Ahmedvini/Jenga-Sustainable-FPGA-CubeSat/docs/architecture/schematic.png

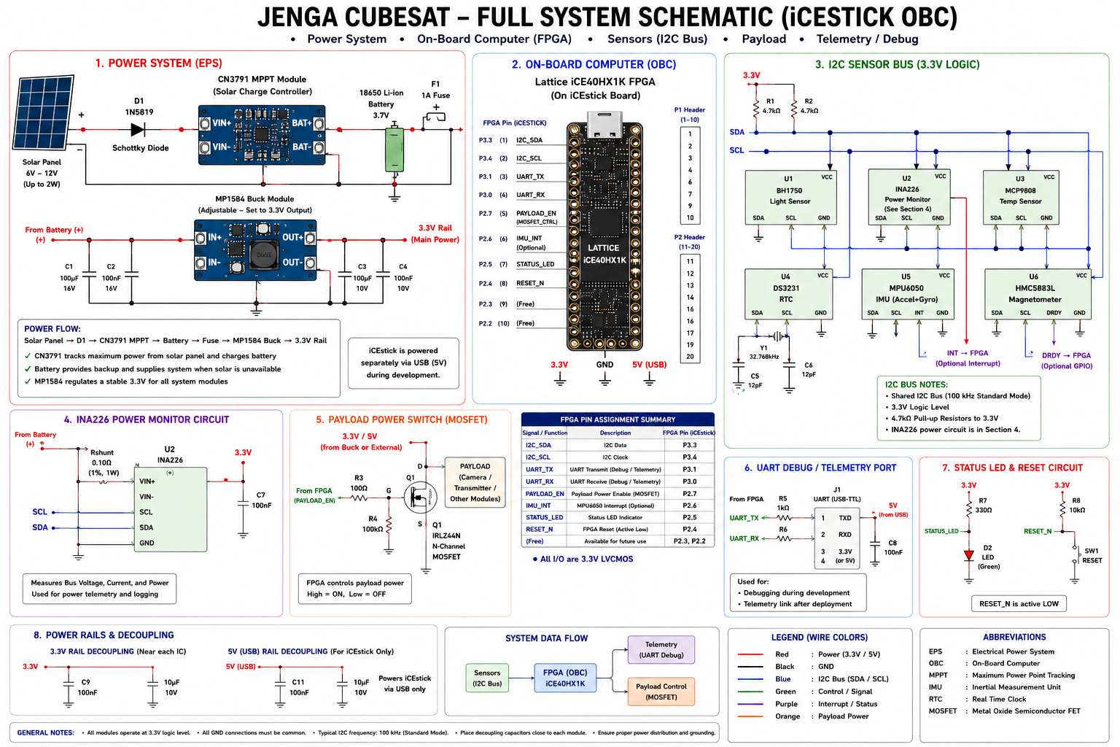
docs/architecture/schematic.png
