Ahmedvini/Jenga-Sustainable-FPGA-CubeSat/docs/architecture/SYSTEM_ARCHITECTURE.md

# Jenga CubeSat Prototype — System Architecture

FPGA-based CubeSat On-Board Computer (OBC) prototype. One iCE40HX1K
FPGA implements all control and data-path logic as HDL finite-state
machines: **no soft CPU, no OS, no DSP macros**. This document covers
hardware, power, sensors, communication, telemetry flow, the OBC
itself, module interactions, and the HX1K resource budget.

## 1. Hardware architecture

Full wiring detail — including iCEstick pin assignments, decoupling,
and the reset/status circuits — is in the drawn schematic:
[`schematic.png`](schematic.png). The block view:

```mermaid
flowchart TB
    subgraph EPS[Electrical power subsystem]
        SP[Solar panel 6V 2W] --> D1[1N5819] --> CHG[CN3791 MPPT]
        CHG --> BAT[18650 Li-ion 1S]
        BAT --> F[1A fuse] --> BUCK[MP1584 buck 3.3V]
    end
    subgraph OBC[OBC — iCEstick iCE40HX1K]
        SCH[Scheduler FSM]
        PWR[Power controller FSM]
        ORB[Orbit controller]
        DP[CAN filter / RLE / FIR]
        I2CM[I2C master FSM*]
        TLM[Telemetry FSM + UART TX*]
    end
    BUCK --> SBUS[3.3V sensor rail]
    SBUS --> S1[MPU6050] & S2[HMC5883L] & S3[BH1750] & S4[INA226] & S5[MCP9808] & S6[DS3231]
    SBUS --> PL[IRLZ44N payload switch]
    PL --> PAY[Payload]
    USB[USB 5V dev power] --> OBC
    I2CM <-->|shared I2C| S1 & S2 & S3 & S4 & S5 & S6
    PWR -->|gate drive| PL
    TLM -->|UART| GS[Laptop ground station]
```

\* Modules marked with an asterisk are staged (see Roadmap); all others
are implemented and synthesized today.

Design rules: single 12 MHz clock domain; all grounds common; FPGA
powered from USB during development (flight variant would take the
3.3 V rail); every off-chip interface is 3.3 V logic.

## 2. Power architecture

Chain: **Solar panel → 1N5819 → CN3791 MPPT → 18650 → 1 A fuse →
MP1584 → 3.3 V rail → sensors / payload switch**.

| Stage | Part | Function | Notes |
| --- | --- | --- | --- |
| Harvest | 6 V 2 W mono panel | ≤ ~330 mA at Vmp ≈ 6 V | indoor demo uses a desk lamp |
| Reverse block | 1N5819 | stops night-time reverse leakage | ~0.3 V drop |
| Charge | CN3791 | PWM MPPT, CC/CV to 4.20 V, single cell | MPPT setpoint resistor-set to panel Vmp |
| Store | 18650 (1S) | 3.0–4.2 V, ~2.5–3.5 Ah | protected holder, one cell only |
| Protect | 1 A fuse | limits fault current | system worst case < 0.5 A |
| Regulate | MP1584 | buck to 3.3 V | **dropout risk below ~3.6 V battery — see risk P1** |
| Distribute | 3.3 V rail | sensors + payload switch | INA226 monitors rail/battery current |

**Risk P1 (known, accepted for the bench):** MP1584 is buck-only; from
a 1S cell the 3.3 V output loses regulation as the battery approaches
~3.5 V. Mitigations, in preference order: (a) treat SOC < ~30% as
safe-mode cutoff (matches the 35% FPGA-activation threshold in the
policy), (b) swap MP1584 for a buck-boost module, (c) run the rail at
3.0 V (all six sensors accept it). Decision tracked in the roadmap.

The FSM policy maps to real hardware as: `comms_power_en` /
`fpga_power_en` (power_controller.v) → IRLZ44N gate (100 kΩ pulldown +
100 Ω series gate resistor, per `schematic.png` section 5). IRLZ44N is
logic-level; at 3.3 V drive keep switched loads ≤ ~2 A.

## 3. Sensor architecture

Single shared I2C bus, **one master** (the FPGA), 100 kHz standard
mode, 4.7 kΩ pull-ups to 3.3 V (disable extra breakout pull-ups if the
combined value drops below ~1.5 kΩ).

| Sensor | Measures | I2C address | Role in mission model |
| --- | --- | --- | --- |
| MPU6050 | 3-axis accel + gyro | **`0x69` (AD0 tied high — required!)** | attitude/tumble telemetry |
| HMC5883L | 3-axis magnetometer | `0x1E` | coarse attitude reference |
| BH1750 | ambient light | `0x23` (ADDR low) | **sunlight/eclipse detection** — can replace the free-running orbit counter with measured orbit state |
| INA226 | bus voltage + current (shunt) | `0x40` | **measured power** — turns simulated savings into live measured evidence |
| MCP9808 | temperature | `0x18` | thermal telemetry |
| DS3231 | RTC | `0x68` (fixed) | mission time-stamping; forces MPU6050 to `0x69` |

**Address plan note:** DS3231 is hard-wired to `0x68`, which is the
MPU6050 default — the MPU6050 breakout's AD0 pin must be strapped high.
No other conflicts exist in this suite.

Polling: one round-robin sensor-sequencer FSM behind the single I2C
master; sample rates follow the power policy (10 Hz-class in sunlight,
1 Hz-class in eclipse), mirroring `simulation/subsystems/sensing_module.py`.

## 4. Communication architecture

| Link | Direction | Use |
| --- | --- | --- |
| I2C (shared, FPGA master) | FPGA ↔ sensors | acquisition + RTC |
| UART (3.3 V, 115200 8N1 target) | FPGA → laptop | telemetry downlink stand-in |
| CAN (modeled) | on-board bus in the reference model | the RTL CAN packet filter demonstrates the flight bus policy; the bench has no physical CAN transceiver |

No RF hardware exists anywhere in the prototype. The UHF radio is a
modeled load in the reference simulation only.

## 5. Telemetry flow

```mermaid
sequenceDiagram
    participant S as I2C sensors
    participant M as I2C master + sequencer
    participant F as FIR filter
    participant R as RLE compressor
    participant E as packet_encoder
    participant B as telemetry FIFO (SB_RAM4K)
    participant U as UART TX
    participant G as Ground station (laptop)
    M->>S: round-robin reads (rate set by orbit state)
    S-->>M: raw samples
    M->>F: signed sensor samples
    F->>R: filtered stream (sunlight only, scheduler-gated)
    R->>E: (value, count) run pairs
    E->>B: 16-bit framed words
    B->>U: drain when comms rail enabled
    U->>G: serial telemetry
```

Implemented today: FIR → RLE path, and the **UART TX with live ASCII
telemetry framing (R1 — done, verified on hardware**, capture in
`docs/bench_uart_capture.txt`). Staged: I2C front-end and the BRAM
FIFO drain FSM (R2–R3).

## 6. OBC architecture

The OBC is three cooperating FSMs plus the datapath, all in
`rtl/top/` (top level `fpga_accelerator_top.v` — the name is retained
for synthesis-report traceability):

- **orbit_controller** — free-running orbit tick (95-tick orbit,
  57 sunlight / 38 eclipse), `PRESCALER` parameter scales tick rate
  (1 = full speed for verification; 1,250,000 = ~10 s orbit on the
  iCEstick LEDs). Roadmap: replace/augment with BH1750 (measured
  sunlight) and DS3231 (absolute time).
- **scheduler** — gates workloads by orbit state: compression only in
  sunlight, filtering whenever packets arrive.
- **power_controller** — comms rail follows sunlight; FPGA burst rail
  requires sunlight AND pending work. Drives the IRLZ44N on the bench.

```mermaid
stateDiagram-v2
    [*] --> ECLIPSE_LOW
    ECLIPSE_LOW --> SUN_IDLE: sunlight
    SUN_IDLE --> SUN_BURST: workload_pending
    SUN_BURST --> SUN_IDLE: done
    SUN_IDLE --> ECLIPSE_LOW: eclipse
    SUN_BURST --> ECLIPSE_LOW: eclipse
    note right of SUN_BURST: fpga_power_en=1, comms_power_en=1
    note right of ECLIPSE_LOW: both rails off, low-rate sensing
```

(Safe-mode/low-SOC shedding exists in the Python policy
(`fpga_activation_policy`) and the reference scenarios; bringing the
SOC threshold into the RTL requires INA226 data — roadmap R4.)

## 7. Module interaction diagram

```mermaid
flowchart LR
    ORB[orbit_controller] -->|sunlight| SCH[scheduler] & PWR[power_controller]
    STIM[packet_ready / can_id / bytes] --> SCH
    SCH -->|run_filter| CAN[can_packet_filter]
    SCH -->|run_compression| RLE[rle_compressor]
    STIM -->|sensor_sample| FIR[fir_filter]
    SCH -->|workload_pending| PWR
    PWR --> EN[fpga_power_en / comms_power_en]
    CAN & RLE & FIR --> OUT[valids + payload/run/sample outputs]
    subgraph staged
        I2CM[i2c_master + sequencer] -.-> FIR
        RLE -.-> ENC[packet_encoder] -.-> FIFOB[telemetry_buffer] -.-> UARTTX[uart_tx]
    end
```

## 8. iCE40HX1K resource budget

Measured (nextpnr, `rtl/synthesis_reports/icestick/`, 2026-07-06 build
with live UART telemetry): **922 / 1280 LC (72.0%)** including the demo
wrapper and telemetry framing; core alone 157 LUT4 / 120 FF; 0 of 16
BRAM tiles used; Fmax ≈ 109 MHz vs 12 MHz required.

| Addition | LC | Basis |
| --- | ---: | --- |
| UART TX + ASCII telemetry framing | **495 (done, measured)** | R1 landed 2026-07-06; the 41-char frame mux + counters dominate, not the UART itself |
| I2C master (byte-level FSM, 100 kHz) | 150–250 | typical minimal open-source masters |
| Sensor sequencer + result store | 150–300 | round-robin FSM; results in **SB_RAM4K, not FFs** |
| Telemetry FIFO drain integration | 50–100 | framing already built; FIFO in BRAM |
| Payload switch control + soft-start | 10–30 | counter + comparator |
| **Projected total (with today's 922)** | **~1280–1600** | **100–125% of HX1K — over budget without the mitigations below** |

Fit plan for R2 (nextpnr routing degrades above ~85% ≈ 1090 LC): first
move the 41-char ASCII frame mux into an SB_RAM4K message ROM — the
measured R1 cost shows the framing, not the UART, is the expensive part
(recovers roughly 200–300 LC); keep all buffering in the 16 unused BRAM
tiles; one shared I2C master (never per-sensor logic); single clock
domain; no multipliers (FIR stays shift-add); width-minimize counters;
drop the CAN demo path from the board build (−~60 LC) if still needed.
Growth path: iCE40UP5K (5280 LC, 30× BRAM + SPRAM) with the identical
open-source flow.
