Ahmedvini/Jenga-Sustainable-FPGA-CubeSat/results/reports/bench_evidence_sheet.md

# Jenga Bench Circuit — Simulated Electrical Evidence Sheet

Generated by `python3 simulation/bench/circuit_model.py` —
deterministic behavioral simulation of the full power chain in
`docs/architecture/schematic.png` (solar -> 1N5819 -> CN3791 MPPT ->
18650 -> 1A fuse -> MP1584 buck -> 3.3V rail -> sensors + payload
switch). All stage parameters are datasheet typicals; see
Assumptions.

## 1. Stage models

| Stage (schematic §) | Model | Key parameters |
| --- | --- | --- |
| Solar panel (§1) | rated-power source | 2.0 W, Vmp 6.0 V, Voc 7.2 V |
| 1N5819 (§1) | series Vf drop | Vf 0.30 V -> 95% transfer |
| CN3791 MPPT (§1) | CC/CV behavioral charger | eff 87%, CV 4.20 V, Imax 2.0 A |
| 18650 (§1) | OCV curve + IR | 2600 mAh, Rint 50 mΩ |
| 1 A fuse (§1) | current limit check | rating 1.0 A |
| MP1584 (§1) | efficiency + dropout | eff 85%, Vout 3.3 V, Vin(min) 3.6 V |
| IRLZ44N (§5) | Rds(on) switch | 50 mΩ at Vgs 3.3 V |

## 2. 3.3 V rail budget (per mode)

| Load | I2C | Active (mA) | Low-rate (mA) |
| --- | --- | ---: | ---: |
| MPU6050 IMU (accel+gyro) | `0x69` | 3.80 | 0.050 |
| HMC5883L magnetometer | `0x1E` | 0.10 | 0.005 |
| BH1750 light sensor | `0x23` | 0.12 | 0.010 |
| INA226 power monitor | `0x40` | 0.33 | 0.330 |
| MCP9808 temp sensor | `0x18` | 0.20 | 0.100 |
| DS3231 RTC | `0x68` | 0.20 | 0.200 |
| I2C pull-ups (avg, 2x4.7k) | `-` | 0.30 | 0.050 |
| Payload via IRLZ44N (avg 10% duty) | - | 5.00 | 0 |
| **Total (avg)** | | **10.05** | **0.745** |

Average rail power: sunlight-active **33.2 mW**, eclipse/safe low-rate **2.46 mW**.

## 3. Peak current and fuse margin

- Worst-case rail current (all sensors active + payload on): **55.0 mA**
- Worst-case fuse (buck-input) current at 0% SOC battery: **71 mA**
- **Fuse margin: 14× under the 1 A rating**

## 4. MP1584 dropout floor vs safe-mode policy

- Buck regulation requires battery ≥ 3.6 V under load
- Simulated electrical floor: **27.5% SOC**
- Policy safe-mode threshold: **35% SOC** (FPGA activation policy) — **7.5 points above** the
  electrical floor, so the scheduler sheds load before the converter
  ever reaches dropout (risk P1 mitigated by policy).

## 5. Orbit simulation (10 orbits, 1 s steps, 57/38 min sun/eclipse)

| Metric | Value |
| --- | ---: |
| Energy harvested per orbit | 448.8 mWh |
| Rail energy consumed per orbit | 33.06 mWh |
| Battery-side consumption per orbit | 38.90 mWh |
| Energy margin | 91.3% surplus |
| SOC drop per eclipse | 0.017 % |
| SOC range across run | 60.0% – 100.0% |
| Buck dropout events | 0 |

The chain is massively energy-positive: the panel recharges an
entire eclipse's discharge within minutes of re-entering sunlight,
and the battery sits in CV/float for most of the sunlit phase.

## 6. Battery autonomy (no solar input)

- Low-rate mode (eclipse/safe rail): **2424 h (≈ 101 days)**
- Active mode (sensors + payload duty): **180 h (≈ 7.5 days)**

## 7. Payload switch (IRLZ44N)

- Drop across switch at 50 mA: 2.5 mV
- Dissipation: 0.125 mW — no heatsinking required
- Gate: 3.3 V logic-level drive (100 Ω series, 100 kΩ pulldown per schematic §5)

## 8. Assumptions and limitations

- Behavioral stage models with datasheet-typical parameters; no
  public SPICE models exist for the CN3791/MP1584 modules, so
  switching transients, inrush, and ripple are not modeled.
- The iCEstick FPGA is USB-powered during development (schematic
  §2) and is **not** a load on this battery rail; FPGA core power
  is characterized separately in `rtl/synthesis_reports/`.
- Solar input is modeled at full rating in sunlight; the indoor
  desk-lamp demo delivers a small fraction of it (the energy
  margin absorbs this).
- Sensor currents are datasheet supply currents; bus transaction
  overhead is folded into the pull-up average.
- Roadmap item R5 replaces these simulated figures with live
  INA226 measurements on the assembled bench.

## Reproduce

```bash
python3 simulation/bench/circuit_model.py
```
