Ahmedvini/Jenga-Sustainable-FPGA-CubeSat/results/reports/simulation_summary.md

# Simulation Summary

Generated by `python3 simulation/main.py`.

## Baseline

- Average power: 242.55 mW
- Energy per orbit: 384.04 mWh
- Daily energy: 5821.20 mWh

## Optimized Scenarios

| Scenario | Avg power | Energy/orbit | Energy saved | Battery extension |
| --- | ---: | ---: | ---: | ---: |
| modular_duty_cycled | 126.54 mW | 200.35 mWh | 47.83% | 91.69% |
| hybrid_fpga_burst | 70.41 mW | 111.49 mWh | 70.97% | 244.46% |
| safe_mode_low_battery | 27.28 mW | 43.20 mWh | 88.75% | 789.01% |

The FPGA-hybrid case should be presented as an extension scenario because it
depends on the assumed reduction in radio active time after compression.
