Ahmedvini/Jenga-Sustainable-FPGA-CubeSat/rtl/synthesis_reports/zcu106/schematic.pdf

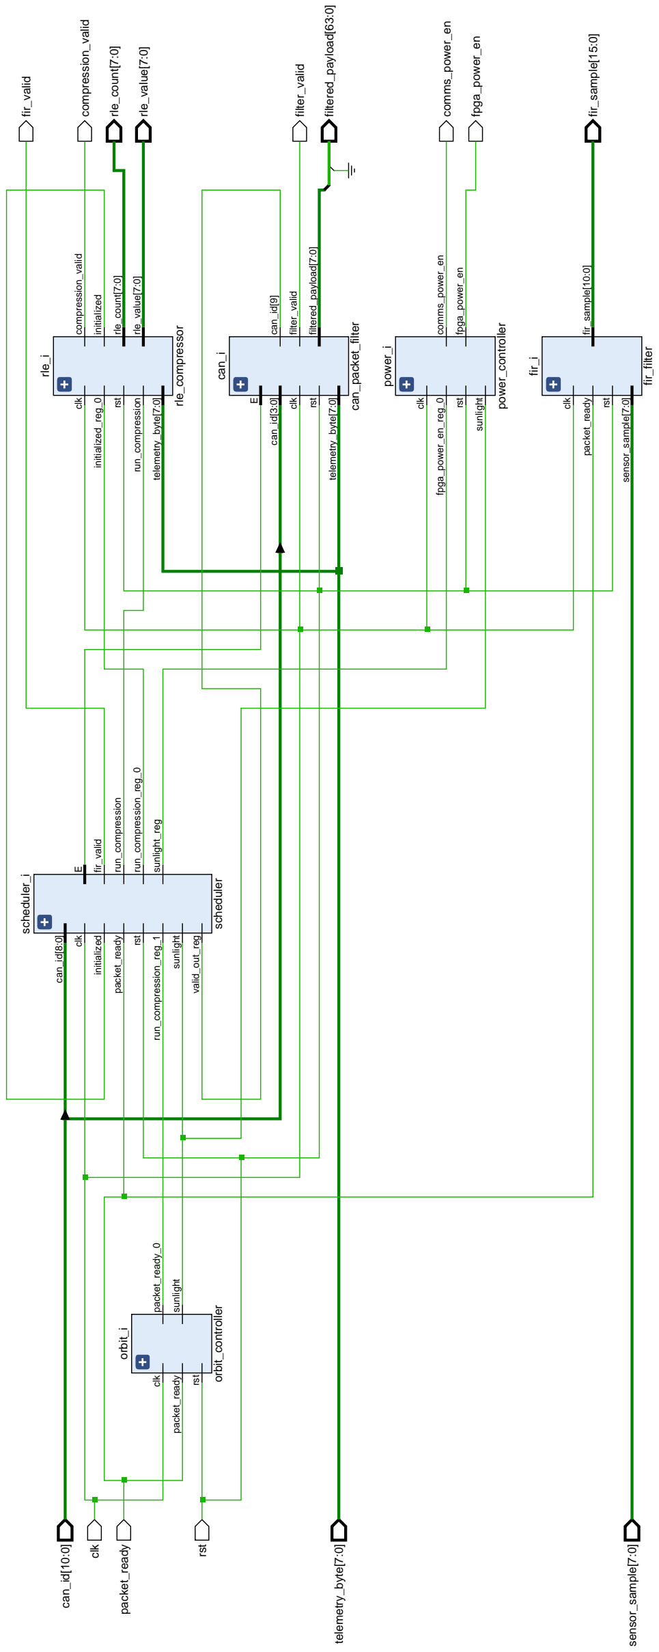
[picture p2: figure]
can_id[10:0]; clk; packet_ready; rst; telemetry_byte[7:0]; sensor_sample[7:0]; orbit_i; orbit_controller; packet_ready_0; sunlight; scheduler_i; scheduler; fir_valid initialized; run_compression; run_compression_reg_0; run_compression_reg_1; sunlight_reg; valid_out_reg; can_id[8:0]; rle_i; rle_compressor; clk compression_valid; initialized initialized_reg_0; rle_count[7:0]; rle_value[7:0]; can_i; can_packet_filter; can_id[9]; clk filter_valid; can_id[3:0]; filtered_payload[7:0]; power_i; power_controller; comms_power_en; fpga_power_en; fpga_power_en_reg_0; fir_i; fir_filter; fir_sample[10:0]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
