Ahmedvini/Jenga-Sustainable-FPGA-CubeSat/video/bench_sim_poc.gif

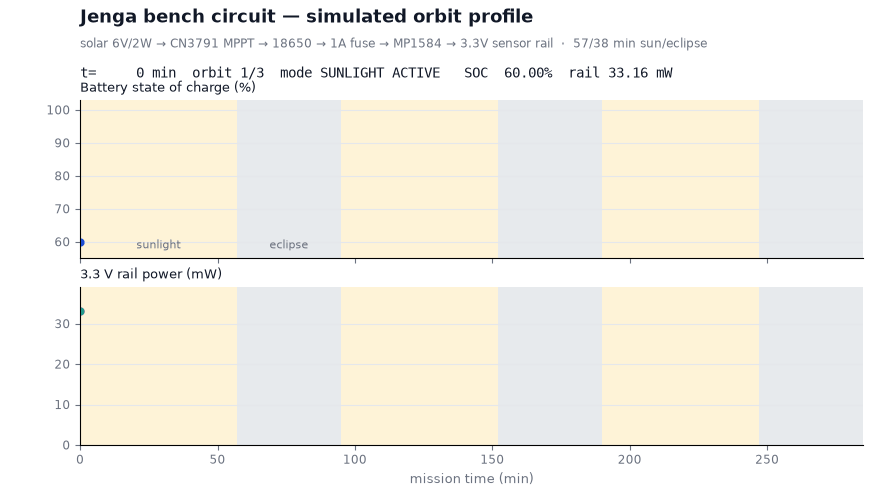
video/bench_sim_poc.gif
