Ahmedvini/Jenga-Sustainable-FPGA-CubeSat/results/csv/bench_power_budget.csv

load | i2c_addr | active_ma | low_rate_ma | active_mw | low_rate_mw
MPU6050 IMU (accel+gyro) | 0x69 | 3.8 | 0.05 | 12.54 | 0.165
HMC5883L magnetometer | 0x1E | 0.1 | 0.005 | 0.33 | 0.017
BH1750 light sensor | 0x23 | 0.12 | 0.01 | 0.396 | 0.033
INA226 power monitor | 0x40 | 0.33 | 0.33 | 1.089 | 1.089
MCP9808 temp sensor | 0x18 | 0.2 | 0.1 | 0.66 | 0.33
DS3231 RTC | 0x68 | 0.2 | 0.2 | 0.66 | 0.66
I2C pull-ups (avg, 2x4.7k) | - | 0.3 | 0.05 | 0.99 | 0.165
Payload via IRLZ44N (avg, 10% sunlight duty) | - | 5.0 | 0.0 | 16.5 | 0.0
