Ahmedvini/Jenga-Sustainable-FPGA-CubeSat/results/csv/baseline_power.csv

scenario | average_power_mw | energy_per_orbit_mwh | daily_energy_mwh
baseline_always_on | 242.54999999999998 | 384.0375 | 5821.2
