Ahmedvini/Jenga-Sustainable-FPGA-CubeSat/results/csv/bench_orbit_timeseries.csv

t_min | mode | illumination | rail_mw | battery_v_loaded | soc_percent | charge_mw
0.0 | sunlight_active | 1.0 | 33.165 | 3.7795 | 60.0046 | 1653.0
1.0 | sunlight_active | 1.0 | 33.165 | 3.7812 | 60.2782 | 1653.0
2.0 | sunlight_active | 1.0 | 33.165 | 3.7828 | 60.5517 | 1653.0
3.0 | sunlight_active | 1.0 | 33.165 | 3.7844 | 60.8251 | 1653.0
4.0 | sunlight_active | 1.0 | 33.165 | 3.7861 | 61.0984 | 1653.0
5.0 | sunlight_active | 1.0 | 33.165 | 3.7877 | 61.3716 | 1653.0
6.0 | sunlight_active | 1.0 | 33.165 | 3.7894 | 61.6446 | 1653.0
7.0 | sunlight_active | 1.0 | 33.165 | 3.791 | 61.9176 | 1653.0
8.0 | sunlight_active | 1.0 | 33.165 | 3.7926 | 62.1904 | 1653.0
9.0 | sunlight_active | 1.0 | 33.165 | 3.7943 | 62.4631 | 1653.0
10.0 | sunlight_active | 1.0 | 33.165 | 3.7959 | 62.7357 | 1653.0
11.0 | sunlight_active | 1.0 | 33.165 | 3.7975 | 63.0081 | 1653.0
12.0 | sunlight_active | 1.0 | 33.165 | 3.7992 | 63.2805 | 1653.0
13.0 | sunlight_active | 1.0 | 33.165 | 3.8008 | 63.5527 | 1653.0
14.0 | sunlight_active | 1.0 | 33.165 | 3.8024 | 63.8248 | 1653.0
15.0 | sunlight_active | 1.0 | 33.165 | 3.8041 | 64.0968 | 1653.0
16.0 | sunlight_active | 1.0 | 33.165 | 3.8057 | 64.3687 | 1653.0
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
