Ahmedvini/Jenga-Sustainable-FPGA-CubeSat/results/graphs/battery_cycles.png

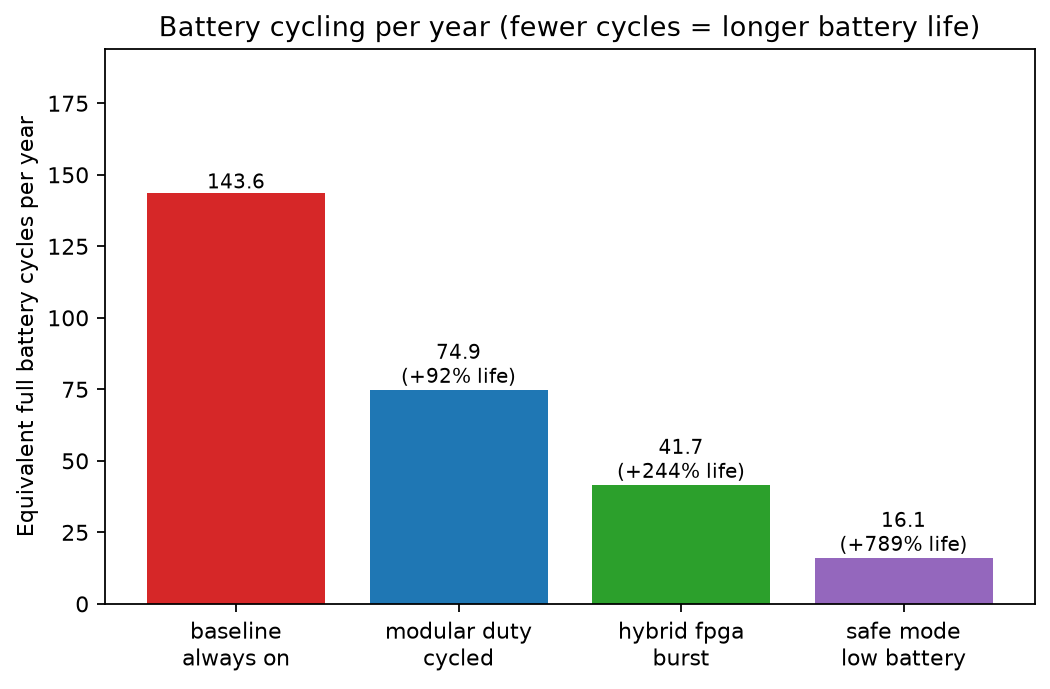
results/graphs/battery_cycles.png
