Ahmedvini/Jenga-Sustainable-FPGA-CubeSat/results/graphs/bench_orbit_profile.png

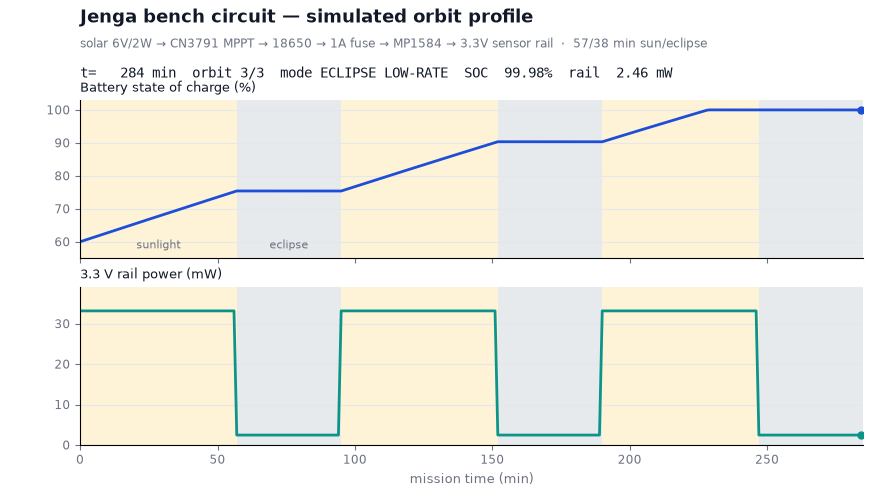
results/graphs/bench_orbit_profile.png
