Ahmedvini/Jenga-Sustainable-FPGA-CubeSat/results/graphs/power_vs_time.png

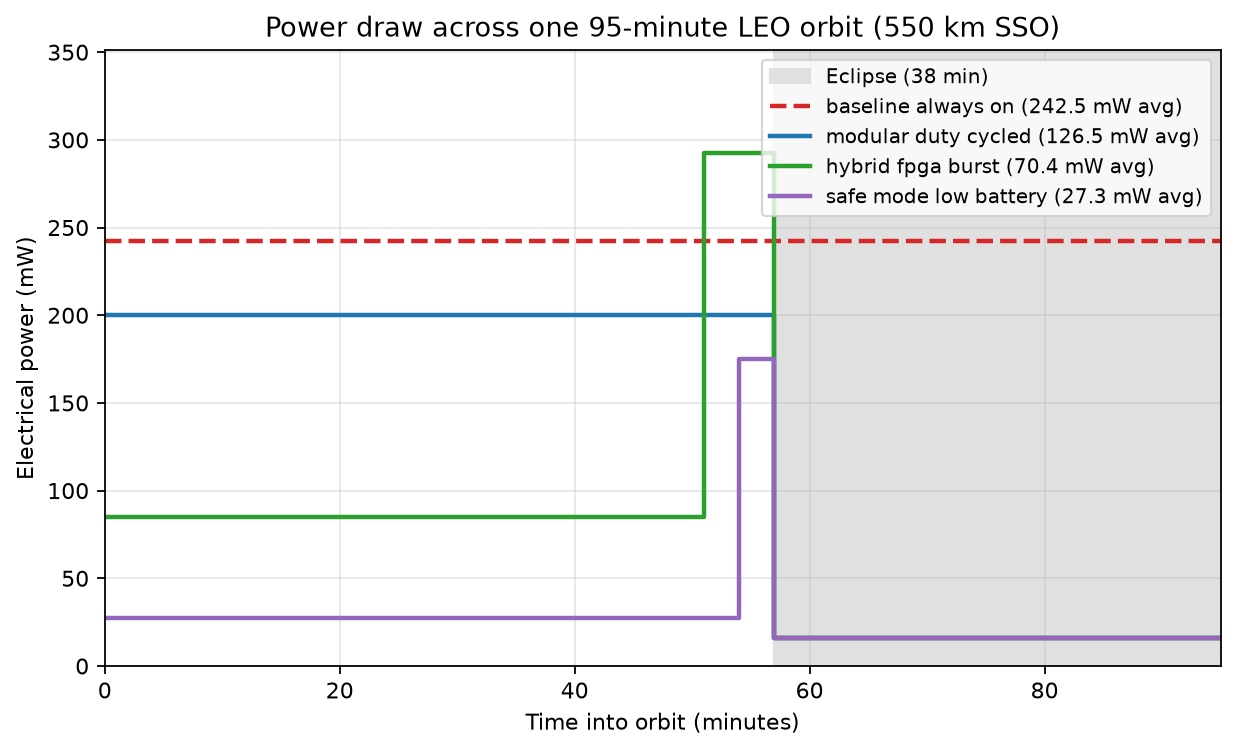
results/graphs/power_vs_time.png
