Ahmedvini/Jenga-Sustainable-FPGA-CubeSat/results/graphs/scenario_comparison.png

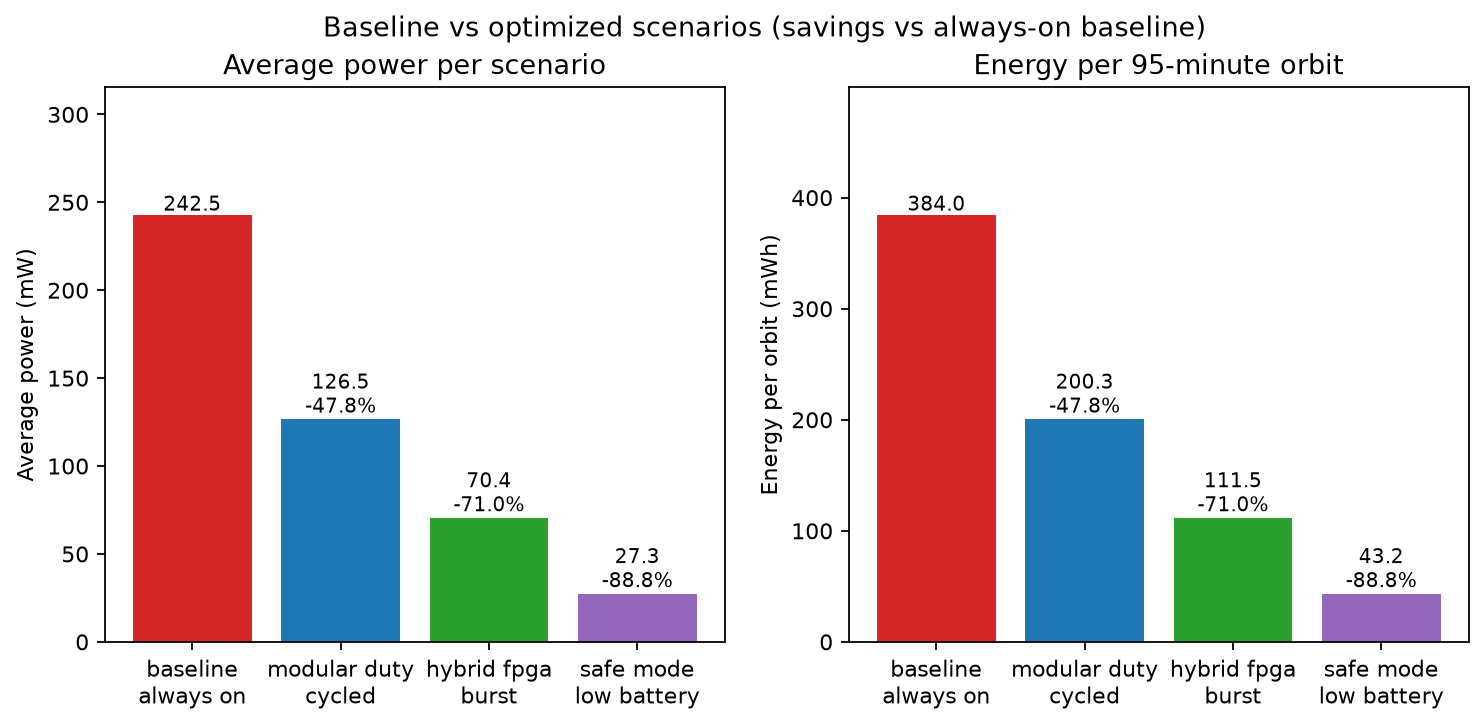
results/graphs/scenario_comparison.png
