Ahmedvini/Jenga-Sustainable-FPGA-CubeSat/(commit log)

2026-07-02 Add final-phase deliverables and evidence fixes (P0+P1)
    - Add Final Evidence Sheet, Equipment & Safety Declaration, AI Disclosure
    - Add backup demo video script and 5-minute presentation slide outline
    - Replace plotting placeholder with real matplotlib plots wired into main.py
    (power vs time, scenario comparison, battery cycles)
    - Make all three RTL testbenches self-checking against golden models with
    PASS/FAIL output; run_iverilog.sh now exits nonzero on any failure
    - Add safe_mode_low_battery operating case plus tests (10/10 passing)
    - Correct stale README claims (iverilog availability, phantom folders) and
    document the PMEP C demo as a runnable artifact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
    [battery_lifetime.csv, optimized_power.csv, orbit_energy.csv, scenario_phase_power.csv]
2026-07-02 Add Vivado implementation evidence for ZCU106 and flight-class targets
    - Scripted out-of-context Vivado flow (batch + GUI Tcl console) with
    100 MHz OOC constraints; GUI project generator with testbenches
    preloaded for xsim
    - Real utilization/timing/power reports for ZCU106 (Zynq UltraScale+
    XCZU7EV, development target) and Zynq-7010 (28 nm Spartan-class
    fabric, flight reference): 44/43 LUTs, 90 FFs, timing met at 100 MHz,
    1-2 mW dynamic
    - Expose accelerator datapath outputs as top-level ports so synthesis
    cannot trim them
    - Document the two-target framing in README, evidence sheet, and AI
    disclosure: ZCU106 validates the toolflow, the flight power model
    stays on the low-power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
2026-07-02 Add open-source iCE40HX1K (iCEstick) flow with consolidated report
    - Yosys -> nextpnr-ice40 -> icepack -> icetime Makefile flow, no
    programming step (no hardware attached)
    - Evaluation wrapper (LFSR stimulus, LED-folded outputs) works around the
    HX1K's I/O limit without letting synthesis trim core logic
    - Minimal PCF: 12 MHz clock pin 21 + five LEDs, placeholder pin listings
    - Results: fits at 280/1280 LCs (21.9%), 0 BRAM/DSP, 12 MHz timing
    passed with +73.9 ns slack, Fmax ~106 MHz
    - Consolidated REPORT.md: portability review, utilization, timing/WNS,
    power caveats, schematic, three-target cross-vendor comparison
2026-07-02 Make iCEstick build deployable: LED orbit demo, prog target, HW declaration
    - orbit_controller gains a PRESCALER parameter (default 1 = original
    netlist; testbenches and Vivado evidence unaffected), passed through
    fpga_accelerator_top
    - iCEstick wrapper now runs a human-speed demo: ~10 s orbit on the green
    LED, comms/FPGA rails on D1/D2, pulse-stretched processing and datapath
    activity on D3/D4, packets arriving in visible bursts
    - Add `make prog` (iceprog) target, kept out of `make all` so the flow
    still runs without hardware
    - Rebuilt reports: 427/1280 LCs (33.4%, core alone 157 LUT4), 12 MHz
    timing PASSED with +73.7 ns slack; README and REPORT.md synced
    - Equipment & Safety De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
2026-07-02 Add CubeSat OBC architecture docs and BOM
    CN3791/18650/MP1584 power chain, 6-sensor shared-I2C suite (with
    address plan: MPU6050 AD0 high to avoid DS3231 0x68 collision),
    telemetry flow, OBC FSM roles, module interactions, and an iCE40HX1K
    resource budget for the staged I2C/UART/telemetry modules.
2026-07-02 Update README.md: Rename project to Jenga and enhance description of FPGA-based CubeSat OBC prototype
2026-07-03 Safety declaration: declare 18650/CN3791/solar bench hardware
    The previous version stated 'no lithium cells', which is no longer
    true. Now declares the single 18650 (protected holder, CC/CV-only
    charging, 1 A fused discharge), the 2 W solar panel, MP1584, IRLZ44N
    payload switch, and the final six-sensor I2C list, plus a USB-only
    fallback if the venue restricts loose cells.
2026-07-03 Align evidence sheet and power model docstring with prototype/reference split
    No numbers changed. Evidence sheet: core function notes the OBC is FPGA
    FSMs in the prototype; test conditions gain a bench-prototype bullet
    clarifying headline figures come from the reference simulation.
    power_model.py docstring marks the load table as the flight reference
    dataset.
2026-07-03 RTL: document OBC roles in module headers; mark uart_debug as stub
    Comment-only, netlist-identical: verified 10/10 Python tests and all
    three self-checking Icarus testbenches still pass.
2026-07-03 Add full system schematic and reference it from docs
    Wires the drawn Jenga schematic (EPS, iCEstick pinout, I2C bus, INA226
    monitor, IRLZ44N payload switch, UART port) into the architecture doc,
    BOM (gate resistor values harmonized to the schematic), and README.
2026-07-03 Refresh stale core stat report (regenerated after clean rebuild)
    Full iCEstick flow re-verified on current RTL: 427/1280 LC (33.4%),
    0 BRAM, icetime 9.62 ns (103.98 MHz), 12 MHz constraint PASSED — all
    identical to committed evidence. Only delta: +1 public wire (tick_en
    from the PRESCALER generate block); the committed report predated it.
    Cell counts unchanged: 157 SB_LUT4 / 89 SB_CARRY.
2026-07-03 iCEstick: full consolidated report + regenerated placement/routing/schematic views
    REPORT.md rewritten as the complete evidence document: result summary,
    fit verdict, portability review, utilization (fixes stale 5/8 global
    buffer figure - current build uses 8/8), timing (fixes +73.92 vs
    +73.71 WNS inconsistency), power caveat, visual-artifact guide,
    artifact index, cross-vendor comparison (with 2026-07-03 Vivado
    re-verification, WNS +8.249), and the LED demo mapping.
    placed.svg / routed.svg / schematic.svg regenerated from the current
    netlist (previous versions predated the deployable-wrapper rebuild).
    nextpnr_report.json and icetime_timing.rpt came out byte-identical -
    the flow is determin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
2026-07-05 Add full bench-circuit electrical simulation + generated evidence sheet
    Behavioral, datasheet-parameterized model of every stage in
    docs/architecture/schematic.png: solar panel, 1N5819, CN3791 MPPT
    (CC/CV), 18650 (OCV curve + IR), 1A fuse, MP1584 buck (efficiency +
    dropout), six-sensor 3.3V rail budget, and the IRLZ44N payload switch.
    Time-stepped at 1s over 10 orbits with the 57/38-min sun/eclipse
    profile. No public SPICE models exist for the CN3791/MP1584 modules,
    so this system-level behavioral simulation is the honest alternative;
    assumptions are documented in the generated sheet.
    Generates results/reports/bench_evidence_sheet.md and two CSVs.
    Key results: 91.3% orbit energy surplus, 0.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
    [bench_orbit_timeseries.csv, bench_power_budget.csv]
2026-07-05 Render bench simulation as animated proof-of-concept clip; link bench results into evidence sheet
    simulation/bench/render_video.py animates the 3-orbit bench circuit
    run (battery SOC + 3.3V rail power, sun/eclipse bands, live readout)
    into video/bench_sim_poc.gif (~22s, 1.7MB) and a static overview frame
    results/graphs/bench_orbit_profile.png. Line colors validated for CVD
    safety; two stacked panels share one time axis (no dual-axis).
    docs/FINAL_EVIDENCE_SHEET.md test conditions now cite the bench
    circuit simulation results (91.3% surplus, 14x fuse margin, 27.5%
    dropout floor vs 35% policy threshold) and point to the generated
    sheet in results/reports/.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
2026-07-05 Document the decided sensor/telemetry pin map in the iCEstick constraints
    UART via the on-board FTDI (pins 8/9, no external wiring); I2C bus,
    payload enable, and IMU interrupt on PMOD J2 (78/79/80/81). Comments
    only - the build and flashed demo are unchanged.
2026-07-07 Add live UART telemetry: real 8N1 TX + frame streaming, verified on hardware
    Implements roadmap R1 on demo day. rtl/common/uart_tx.v is a real
    115200-baud 8N1 transmitter (replaces and deletes the uart_debug stub)
    with a self-checking testbench (golden software receiver decodes the
    wire; suite now 4/4 RTL TBs). The iCEstick wrapper snapshots OBC state
    ~2.9x/s and streams 41-char ASCII frames (frame#, sunlight, burst
    rail, CAN/RLE/FIR counters) through the on-board FTDI channel B (pin
    8, no external wiring).
    Verified end-to-end on the connected board: bitstream flashed (VERIFY
    OK), live frames captured from the serial port. The capture in
    docs/bench_uart_capture.txt shows the scheduler polic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
    [icestick.pcf, icestick_top.v, tb_uart_tx.v, uart_tx.v]
2026-07-07 Add ground-station telemetry monitor; put the hardware moment in the demo run sheet
    tools/telemetry_monitor.py (stdlib-only) decodes the live UART frames
    into an annotated table with sunrise/eclipse-entry events - verified
    against the running board. Demo run sheet step 4 is now the iCEstick +
    live telemetry showpiece, with the honest LFSR-stimulus answer scripted.
